FShahin91/LiquidTankLevel/DatasheetsLinks.md

This file includes links to all used devices datasheets 

* [PIC16F877A](https://ww1.microchip.com/downloads/en/DeviceDoc/39582b.pdf)
* [LCD 1604A-V1.2](https://panda-bg.com/datasheet/2135-091859-LCD-module-TC1604A-02WA0-16x4-STN.pdf)
* [HC-SR04 Ultrasonic](https://cdn.sparkfun.com/datasheets/Sensors/Proximity/HCSR04.pdf)
* [4x3 keypad](https://cdn-learn.adafruit.com/downloads/pdf/matrix-keypad.pdf)
* [HEF4539B dual 4-input MUX](https://pdf1.alldatasheet.com/datasheet-pdf/view/17763/PHILIPS/HEF4539B.html)
* [SN74HC139 dual 2-to-4 deMUX](https://www.ti.com/lit/ds/symlink/sn74hc139.pdf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)
