FShahin91/LiquidTankLevel/(list of files, drawings)

Other design files:
schematic/TankLevel.fzz
