FShahin91/LiquidTankLevel/(threads)

Thread 1 (2022-01-20):

Sensors 3 and 4 don't take readings

FShahin91, 2022-01-20:
While testing on the PCB, sensors connected to 3 and 4 ports don't take any readings.
First debug steps shows no issue with the sensor itself. Suggested approaches for debug:

- [x] Check the code for faulty logic
- [x] Check the PCB for open circuits for these connections (both trigger and each pins).

FShahin91, 2022-01-20:
The code looks fine. No open circuits. However, pins 1 and 2 of the HEF4539B aren't connected correctly:
| Pin # | Current connection | Correct connection |
| :---: | :--------------------: | :-------------------: |
| 1 | To pin A0 of MCU | To GND|
| 2 | NC | To pin A0 of MCU |

1. [ ] Fix the issue on the PCB (itch incorrect connection and wire the correct ones)
2. [ ] If the issue is resolved, apply to schematics

FShahin91, 2022-01-20:
Issue is resolved. PCB design updated and uploaded in [schematic](https://github.com/FShahin91/LiquidTankLevel/tree/main/schematic)

Closed 2022-01-20.
