FShahin91/LiquidTankLevel/include/config.h

/* 
 * File:   config.h
 * Author: Faris Shahin
 * This file has all the necessary configurations for the MCU and it also includes all the header files.
 * Revision: v1.0
 */

#ifndef CONFIG_H
#define	CONFIG_H


#include <xc.h>
#include <stdbool.h>
#include <stdio.h>
#include <stdlib.h>
#include <stdint.h>
#include "lcd.h"
#include "ultrasonic_hcsr04.h"
#include "KeyPad.h"
#include "utility.h"
#include "sm.h"
// CONFIG
#pragma config FOSC = XT        // Oscillator Selection bits (XT oscillator)
#pragma config WDTE = OFF       // Watchdog Timer Enable bit (WDT disabled)
#pragma config PWRTE = OFF      // Power-up Timer Enable bit (PWRT disabled)
#pragma config BOREN = ON       // Brown-out Reset Enable bit (BOR enabled)
#pragma config LVP = OFF        // Low-Voltage (Single-Supply) In-Circuit Serial Programming Enable bit (RB3/PGM pin has PGM function; low-voltage programming enabled)
#pragma config CPD = OFF        // Data EEPROM Memory Code Protection bit (Data EEPROM code protection off)
#pragma config WRT = OFF        // Flash Program Memory Write Enable bits (Write protection off; all program memory may be written to by EECON control)
#pragma config CP = OFF         // Flash Program Memory Code Protection bit (Code protection off)

#define _XTAL_FREQ 4000000L

#endif	/* CONFIG_H */
