FShahin91/LiquidTankLevel/(commit log)

2022-01-16 Add schematics of the system
    The schematic is made using Fritzing. The file also includes PCB design.
    [TankLevel.fzz]
2022-01-20 Update README.md
    - Corrected a typo.
    - Added a small description for the schematics folder.
2022-01-20 Update KeyPad.h
    Fixed the comment in line 19 to match the correct order of the keypad's pins.
    [KeyPad.h]
2022-01-20 Update schematics
    Updated the schematics to resolve issue #1
    [TankLevel.fzz]
